KavinduKariyawasam/Laser_Tripwire_Alarm/Enclosure/Transmitter/Assem1.SLDASM

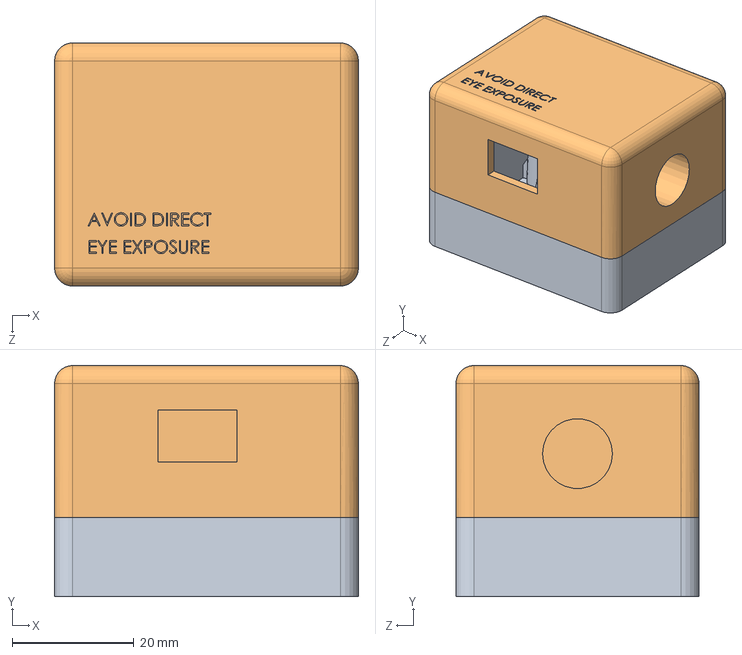
[picture p19: CAD file, 2023-10-13]
Enclosure/Transmitter/Assem1.SLDASM
50.0 x 38.0 x 40.0 mm
bottom
upper
