KavinduKariyawasam/Laser_Tripwire_Alarm/Enclosure/Lower part.SLDPRT

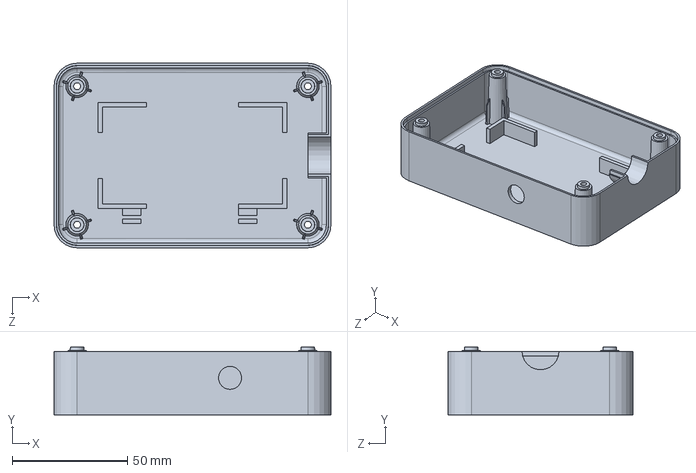
[picture p20: CAD file, 2023-10-13]
Enclosure/Lower part.SLDPRT
120.0 x 29.2 x 80.0 mm
