KavinduKariyawasam/Laser_Tripwire_Alarm/Enclosure/Transmitter/upper.SLDPRT

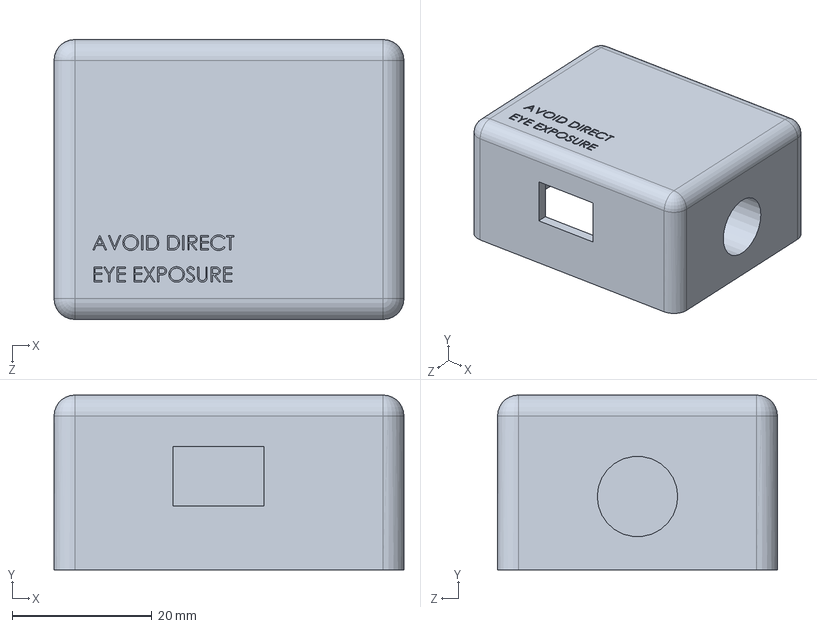
[picture p21: CAD file, 2023-10-13]
Enclosure/Transmitter/upper.SLDPRT
50.0 x 25.0 x 40.0 mm
