KavinduKariyawasam/Laser_Tripwire_Alarm/Enclosure/Transmitter/bottom.SLDPRT

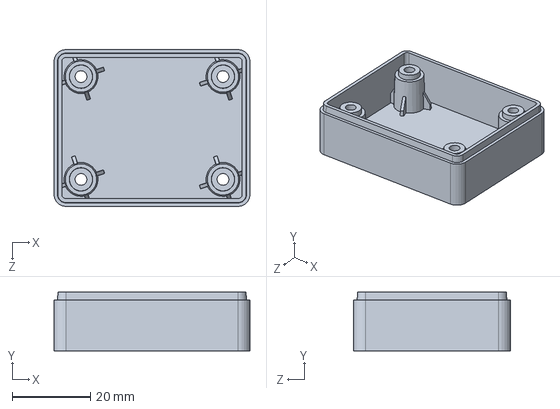
[picture p22: CAD file, 2023-10-13]
Enclosure/Transmitter/bottom.SLDPRT
50.0 x 15.0 x 40.0 mm
