KavinduKariyawasam/Laser_Tripwire_Alarm/(list of files, cad)

Other CAD files:
Enclosure/Upper part.SLDPRT
Enclosure/Transmitter/Part1.SLDPRT
