KavinduKariyawasam/Laser_Tripwire_Alarm/(list of files, drawings)

Other design files:
PCB Design/PCB1.PcbDoc
PCB Design/PCB_Project.PrjPcb
PCB Design/Sheet1.SchDoc
